FG-HST/01-01-hallsonde/documentation.pdf

# A handheld hall probe based on an Arduino Micro

Application for Arduino Uno WiFi XMAS Contest 2015
by Henning Janssen

This is a short documentation about a mobile handheld hall probe, which is based on an Arduino Micro. A battery powered Arduino evaluates via the analog input a hall effect sensor. The measured value will be shown on a display.
With this device it is possible to measure magnetic fields, i.e. the magnetic flux density as a constant and as a time-depending value. It is portable and independent from a power grid.

1 Hardware

The total system consists of a handheld (includes the Arduino, energy supply and display) and a set of external sensors. A picture of the whole measuring system is presented in Figure 1.


Figure 1: The handheld hall probe measuring the magnetic flux density of a permanent magnet

1.1 Set of probes

The magnetic flux density can be measured with different sensitivities. Therefor different hall effect sensors are used. The probes are equipped with ratiometric linear hall effect sensor ICs from Honeywell and Allegro. They need a supply voltage of VCC = 5 V and the output voltage depends linearly from the magnetic flux density. Figure 2 shows the three different sensor in their housings and a rod to hold the device into the measuring area.


Figure 2: Three types of sensor chips with different sensitivities can be used

1.2 Connection between measuring probes and handheld device

The different probe are connected with the handheld device with a 6-wire-ribbon cable. Two wires are used for the power supply. A third wire connects the voltage output of the hall sensor ICs to the handheld. Two of the remaining three wires are used to identify the different hall sensor ICs and thereby the different sensitivities.

1.3 The handheld in itself

The handheld is based on a Arduino Micro and a custom shield. An inside is given by Figure 3. The


Figure 3: View inside the handheld with the Arduino

device is powered by a nine-volt battery. The voltage for the microcontroller is directly regulated with a 7805 (fixed positive voltage regulator). Thus the Arduino Micro is powered via the port "+5V". The output of the 7805 is also used for the sensor chip, the display and the display background LED, too. The LCD is connected to the Arduino Micro in 4-bit mode and without the "rw contol" to minimise the wiring effort. As already mentioned in Chapter 1.2 the Arduino Micro can check automatically which sensor is linked. Therefor two digital ports are used to detect whether the corresponding channel is pulled to ground or 5 V. The measured signal is connected to the analog port "A0". The schematic of the developed shield can be found in Appendix II. The PCB layout was designed with EAGLE. It is shown in Appendix III.

2 Software

The Arduino Micro is flashed by the USB port with the Arduino IDE and Arduino code. The complete code is attached to Appendix I. The LCD is controled by the Arduino Micro using the LiquidCrystal Library. For timing purposes the TimerNull Library is used. It provides the functionality of the timer interrupts of the ATmega 32U4. To access the measured data the variables are initialised as volatile.

2.1 The setup() function

Within the setup() function the LCD will be started and static data will be written.
The measurement should be performed with an averaging. Every single point of measurement shall be taken every 50µs. For this reason the timer interrupt will be set to this time and be attached as interrupt.

2.2 The loop() function

Nothing will be perfomed. The Arduino Micro is just waiting for instructions from the timer interrupt.

2.3 The readHall() function and the sub-functions

Every times the timer interrupts the magnetic flux density will be measured and stored in a collection of all current measuring values. The number of all measuring values is increased by one. When 5000 measurements are performed the average will be calculated and shown on the display. To be able to measure also alternating fields the rms-value will be used as averaging method:

Brms =

vuuu
t

Pn=5000
i=1

Uin,i
1023 ·5000−Uref

kdivider 2

5000

Uin,i

: value returned by analogRead()

Uref: reference voltage which is returned by sensor at B = 0 T

kdivider: divider to convert measured voltage into a flux density, unit: mV
mT
The values Uref and kdivider depend on the type of hall sensor IC and will be set by the function setSensorTyp(). This functions evaluates the digital status (HIGH or LOW) on the inputs "A2"’ and "A3" and sets the sensor specific values to the volatile variables. If no sensor is identified an error is returned to the customer: Sensor?.
Finally the measured magnetic flux density will be shown on the display.

3 Appendix

I The Arduino code

/*
H all s o n d e

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

von Henning J a n s s e n

*/

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

vo id se tup ( )

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

se tSen s o rTyp ( ) ;

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

vo id loop ( ) {
// Warte und t u e n i c h t s

51 }

52
53 | vo id re a dH all ( )
54 | {
55 | i f (5000 == messwertAnz ) showRMS( ) ;

56
57 | messwert = ( ( ( f l o a t ) analogRead ( h a l l P i n ) ) /1023*5000 − h all R e f ) / s e n s o r d i v i d e r ;
58 | messwert = messwert *messwert ;
59 | messwertsammlung += messwert ;
60 | messwertAnz++;
61 | }

62
63 | vo id showRMS( )
64 | {
65 | messwert = s q r t ( messwertsammlung/messwertAnz ) ;
66 | // | m e s sw e r t = messwertsammlung / me s swer tAnz ;
67 | messwertsammlung = 0 ;
68 | messwertAnz = 0 ;

69
70 se tSen s o rTyp ( ) ;

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

80
81 | vo id se tSen s o rTyp ( )
82 | {
83 | S t ri n g senso rTyp ;
84 | pinMode (A2 , INPUT ) ;
85 | pinMode (A3 , INPUT ) ;
86 | i n t typPin4 = di gi t al R e a d (A2) ;
87 | i n t typPin5 = di gi t al R e a d (A3) ;
88 | i f (LOW == typPin4 & LOW == typPin5 ) { | // S e n s o r 1 = SS495A
89 | h all R e f = 2480;
90 | senso rTyp = " SS495A " ;
91 | s e n s o r d i v i d e r = 3 1.25 ;
92 | } e l s e i f (HIGH == typPin4 & LOW == typPin5 ) { | // S e n s o r 2 = SS496A
93 | h all R e f = 2470;
94 | senso rTyp = " SS496A " ;
95 | s e n s o r d i v i d e r = 25 ;
96 | } e l s e i f (HIGH == typPin4 & HIGH == typPin5 ) { | // S e n s o r 3 = A l l e g r o A1302K
97 | h all R e f = 2499;
98 | senso rTyp = " A1302K " ;
99 | s e n s o r d i v i d e r = 13 ;
100 | } e l s e senso rTyp = " Sensor ? " ;

101
102 | l c d . s e t C u r s o r (0 ,1 ) ;
103 | l c d . p r i n t ( senso rTyp ) ;

104
105 }

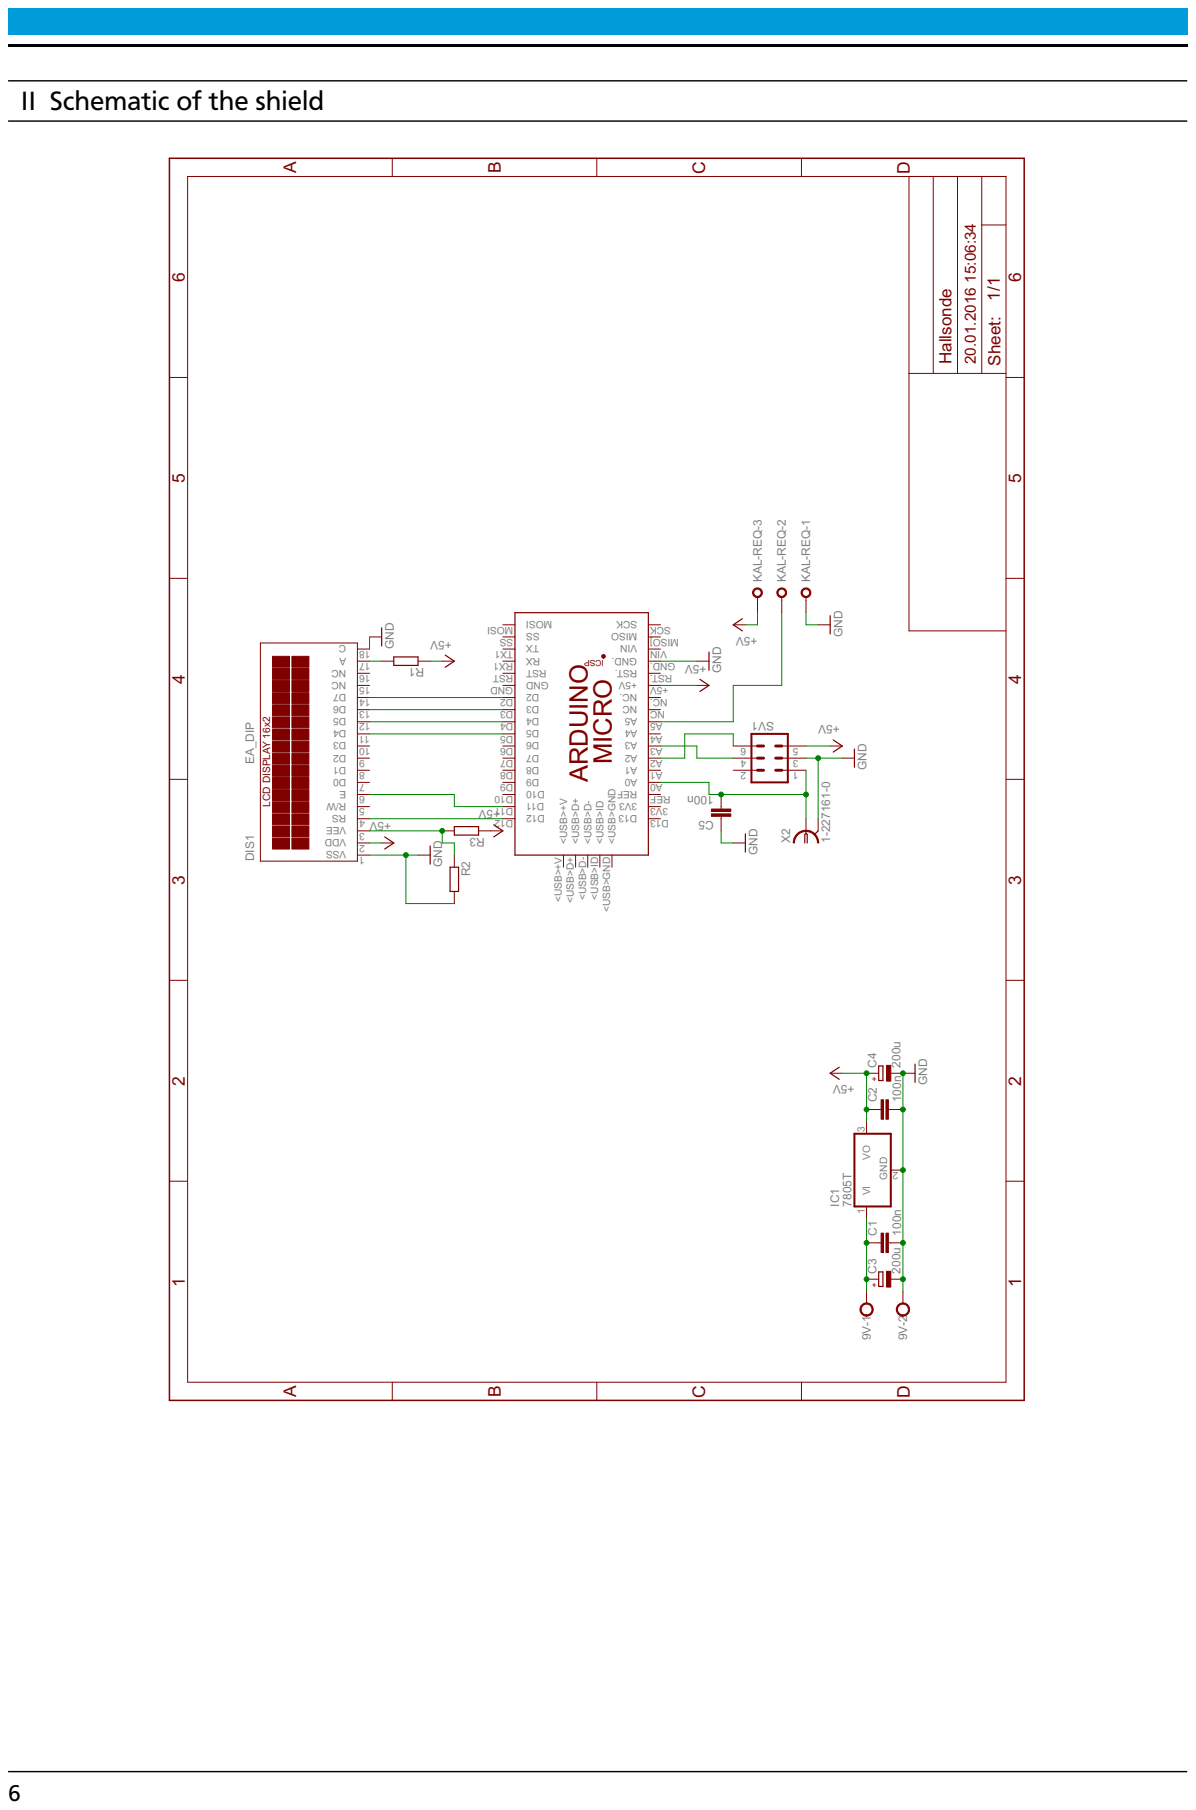
[picture p4: page 6]
EA_DIP; 100n 100n 200u 200u GND; V5+ GND; GND; n001 GND; DIS1 SSV 1 DDV; EEV; DNG; TSR; . TSR; . DNG; FER; <USB>GND; <USB>D+; <USB>+V; I SOM; OSI M; ] OSI M; KCS; <USB>ID; KAL-REQ-1; KAL-REQ-2; KAL-REQ-3; LCD DISPLAY 16x2; Hallsonde; 1/1 Sheet:; ARDUINOPSCI MICRO

II Schematic of the shield

<USB>+V NI V NI V

<USB>D- <USB>D- <USB>D+

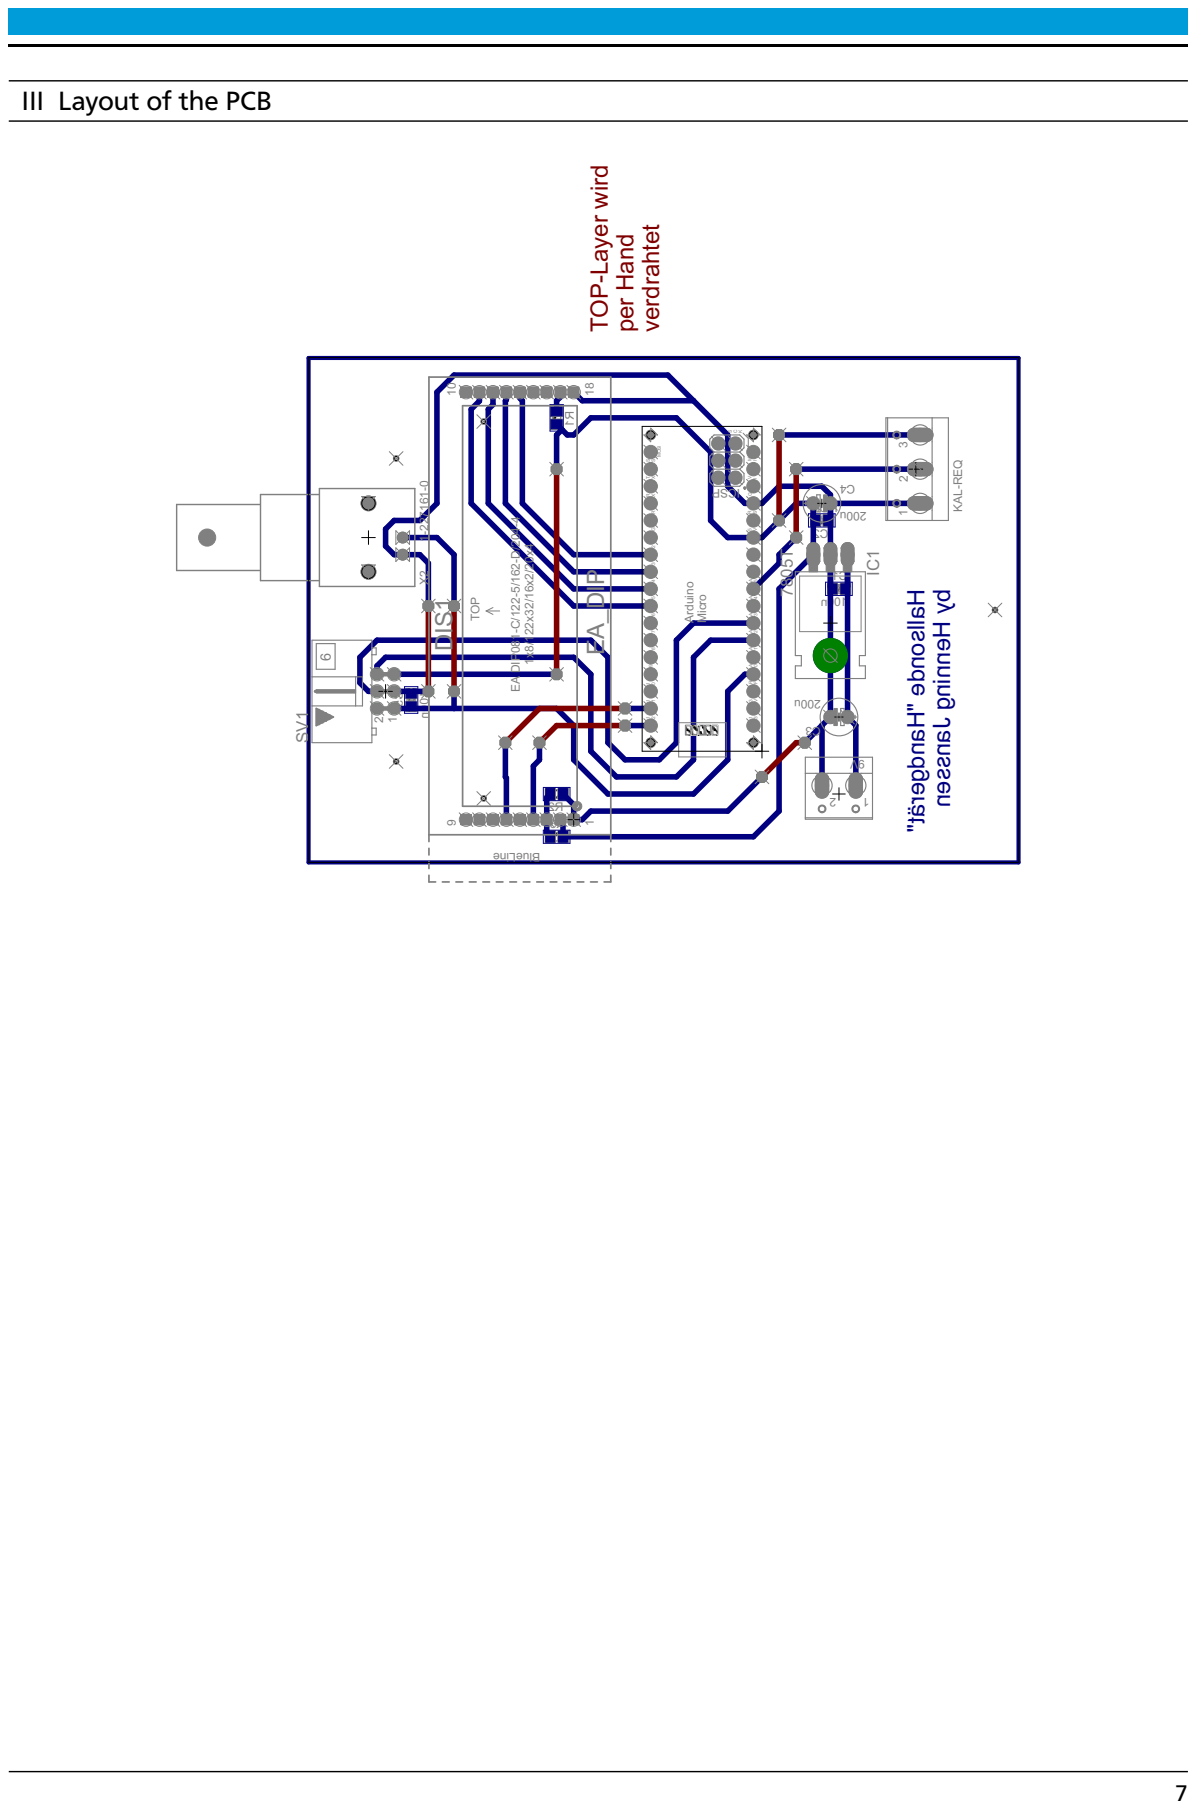
[picture p5: page 7]
per Hand; verdrahtet; EA DIP081-C/122-5/162-D/204-4; 1x8/122x32/16x2/20x4 TOP; Arduino Micro; S MOSI; DIS1; KAL-REQ; X2 EA_DIP

III Layout of the PCB

TOP-Layer wird

Hallsonde "Handgerät" by Henning Janssen
