FG-HST/01-01-hallsonde/Layout/Hallsonde_Schematic.pdf

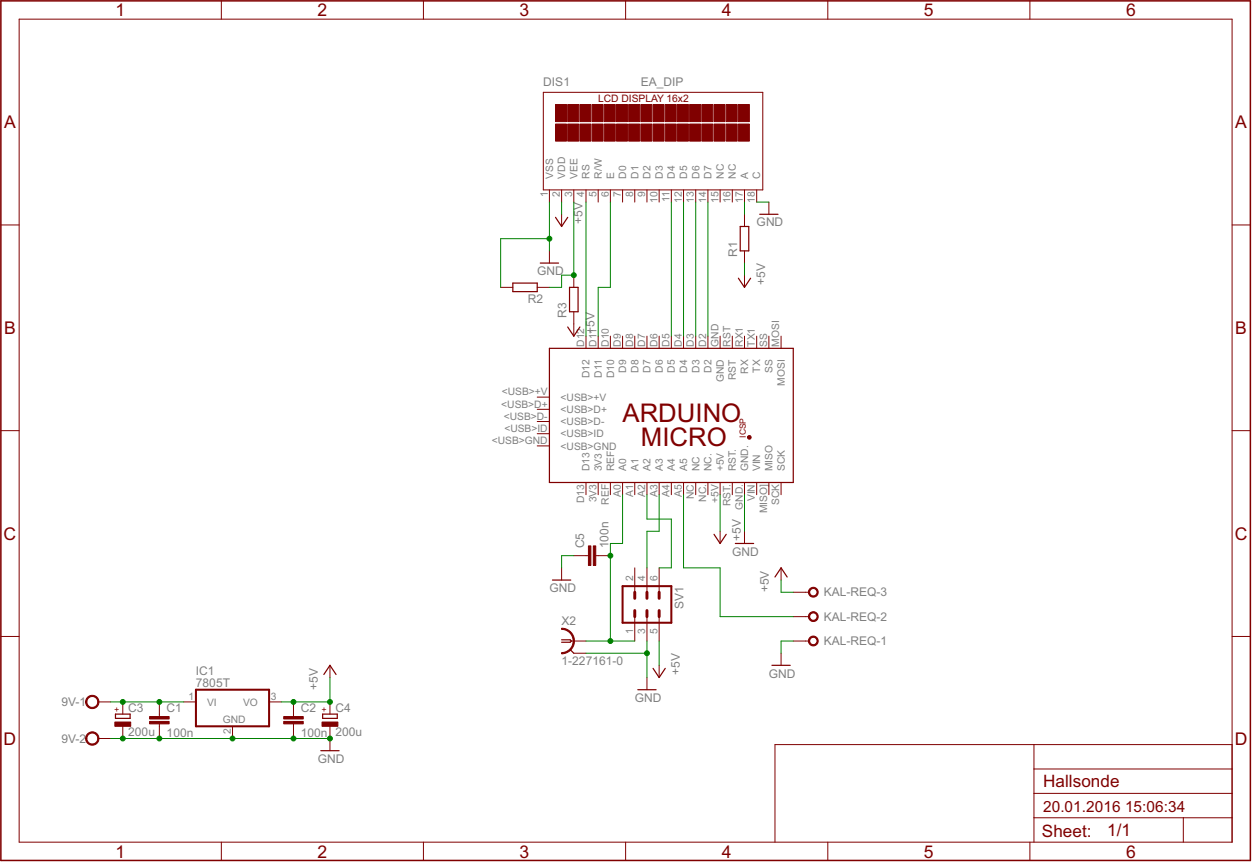
[picture p6: page 1]
