FG-HST/01-01-hallsonde/Layout/Hallsonde_board.pdf

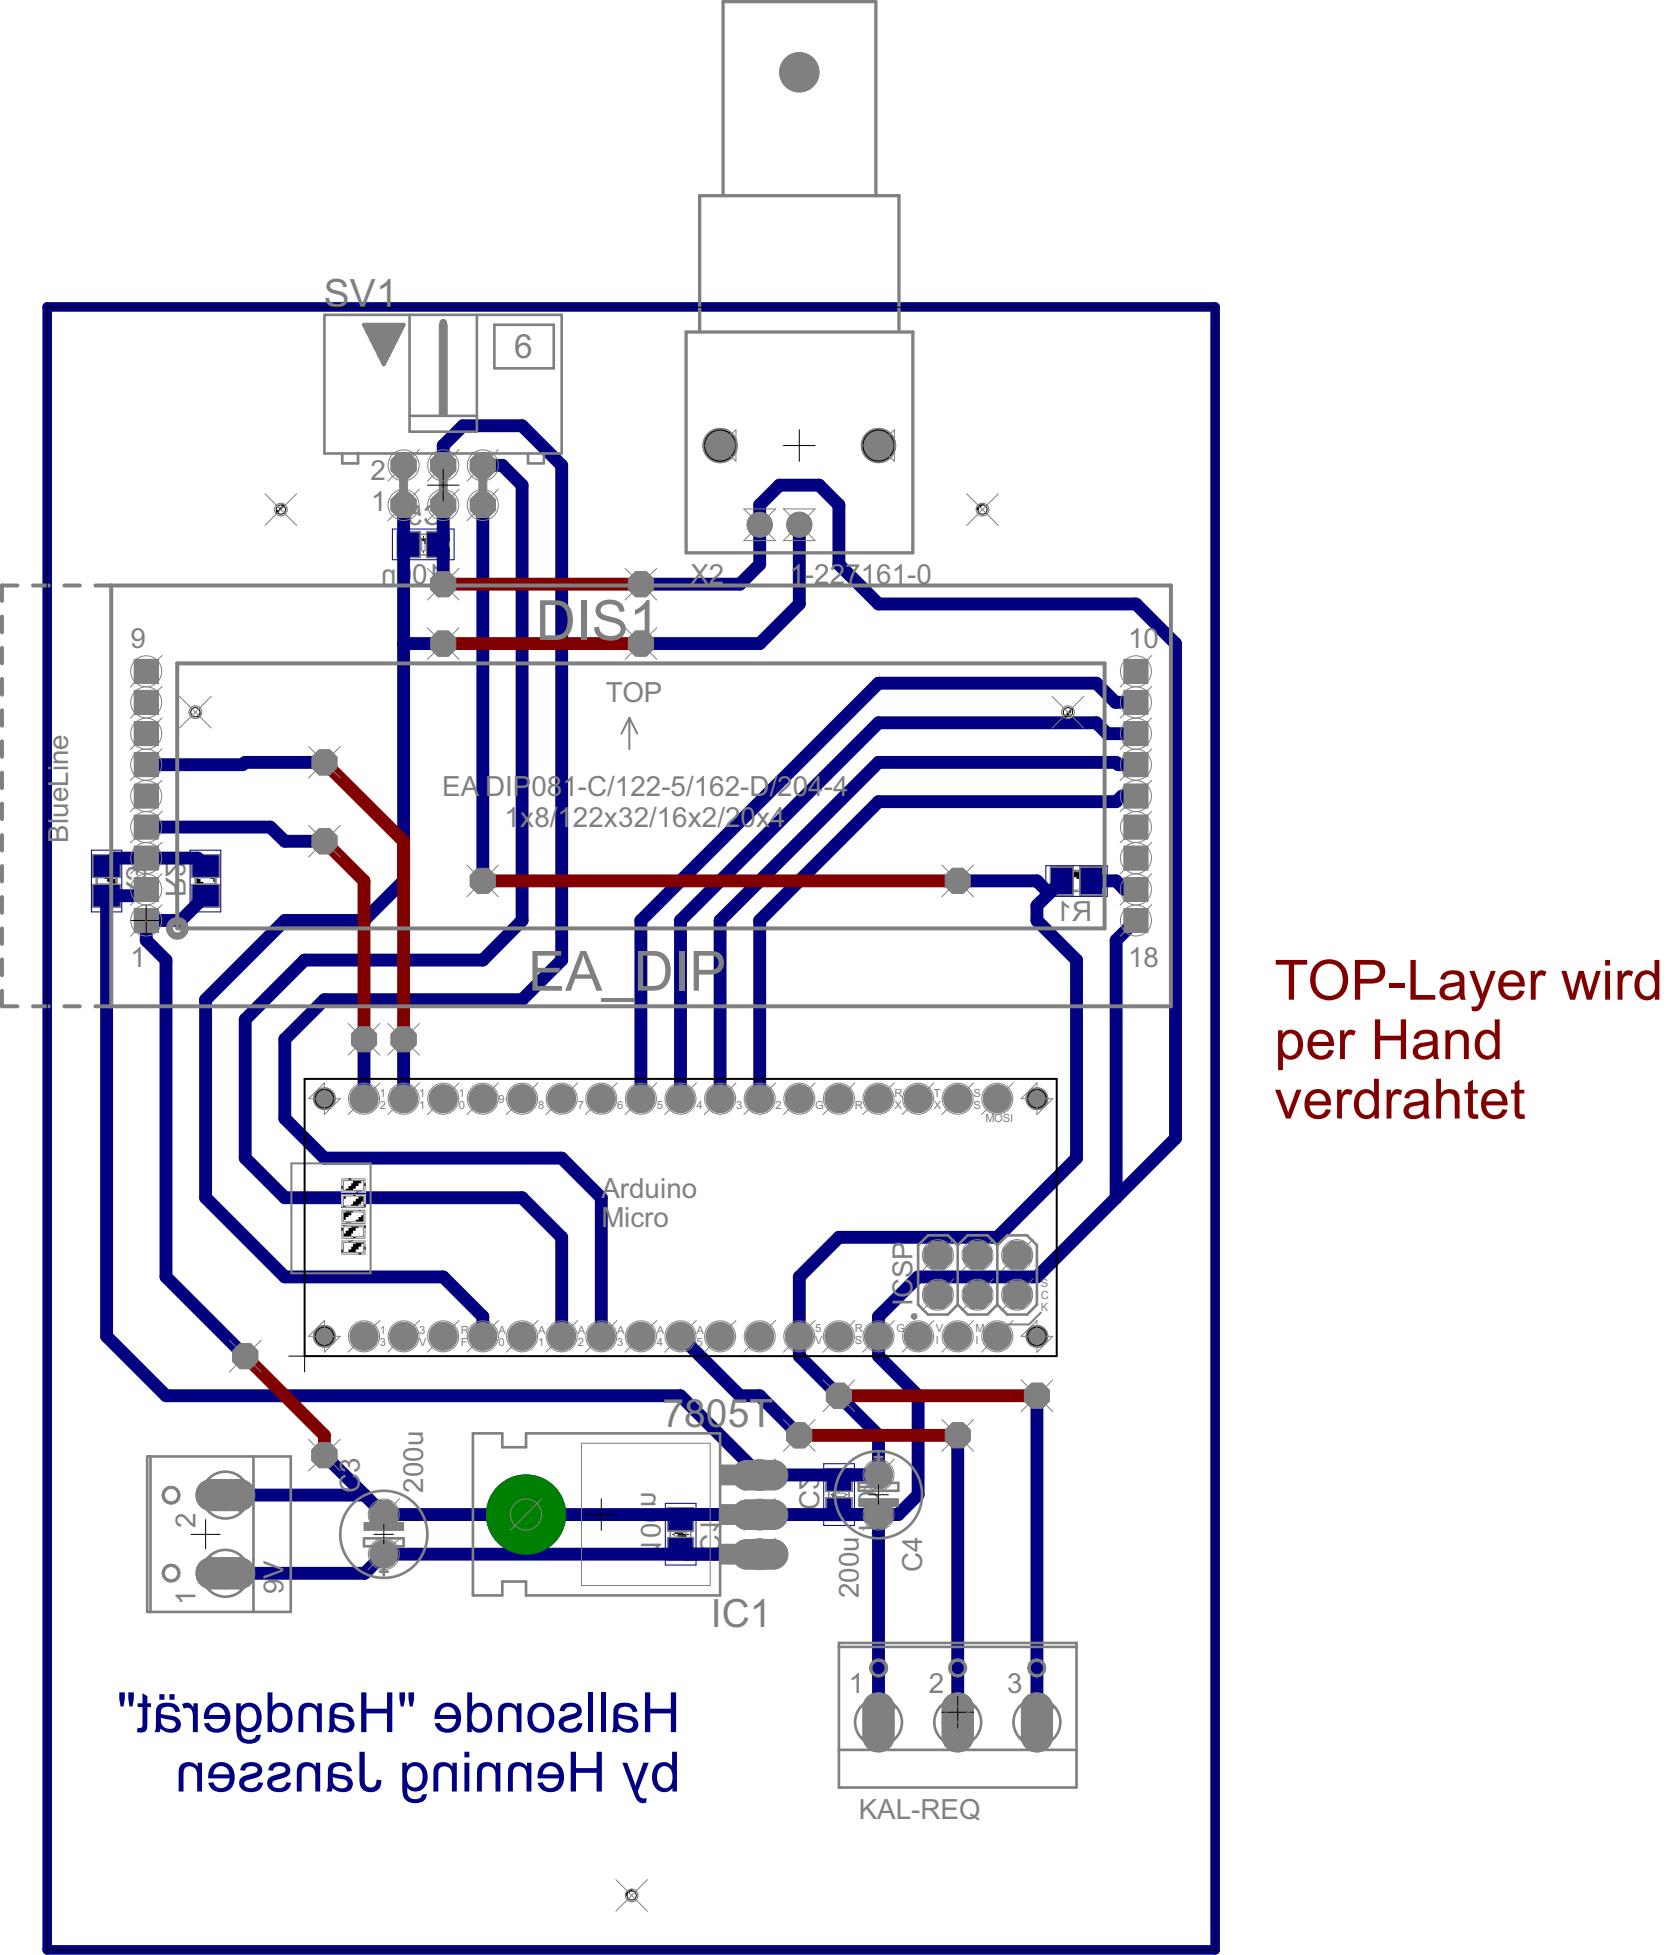
[picture p7: page 1]
