FG-HST/01-01-hallsonde/Layout/Hallsonde.brd

## EAGLE design Layout/Hallsonde.brd (2016-01-20)

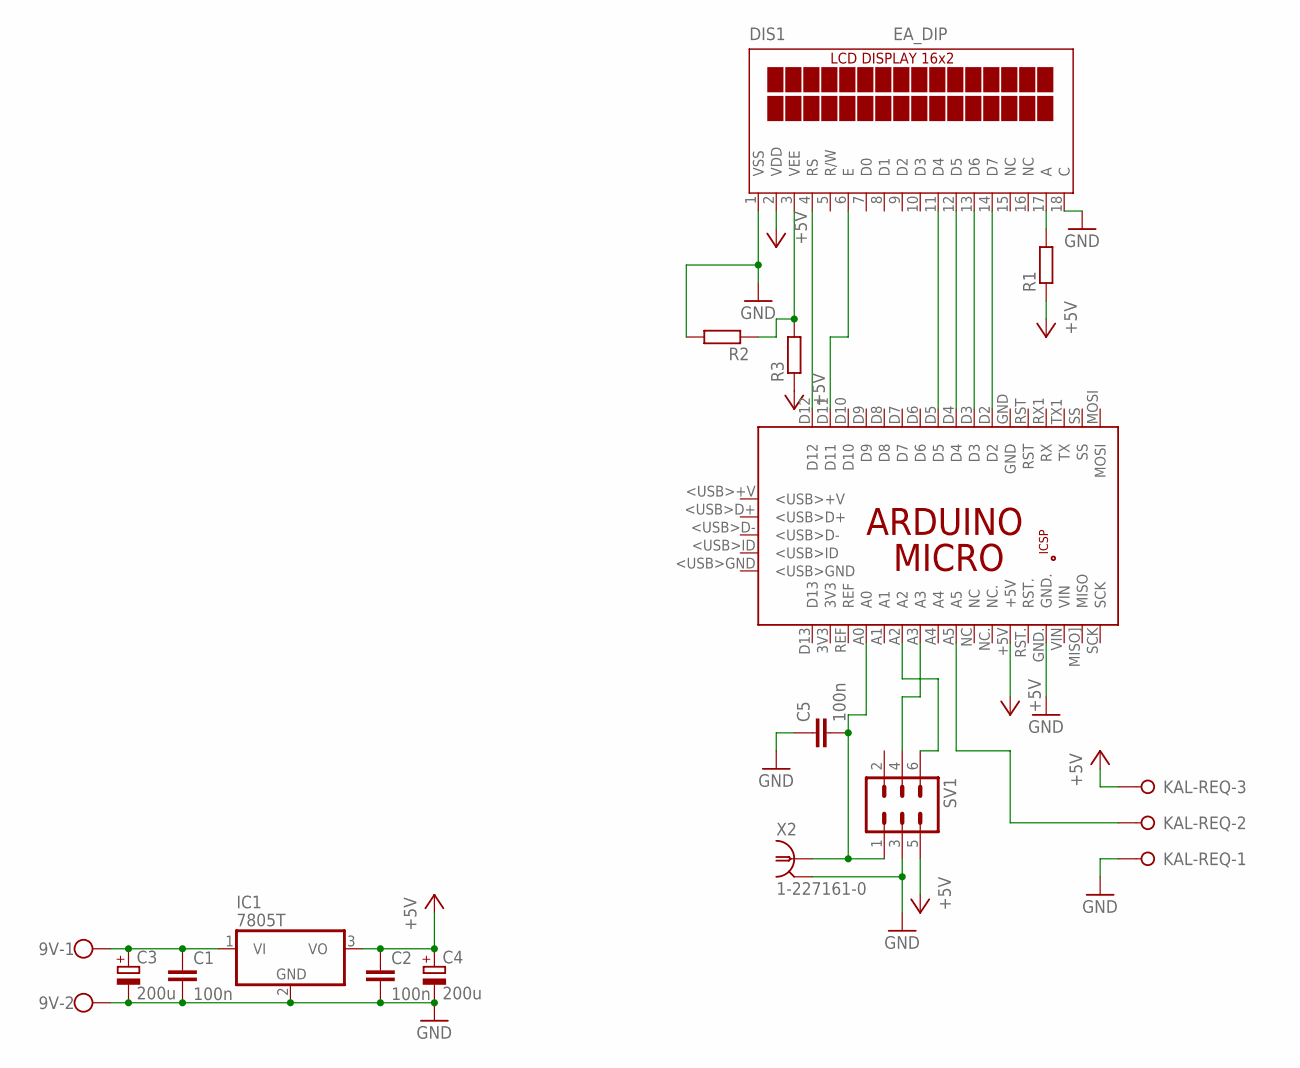
[picture p8: schematic Hallsonde.sch]

Parts:
9V: W237-102
C1, C2, C5: 100n; C0805
C3, C4: 200u; E2,5-6E
DIS1: EA_DIP
IC1: 7805T; TO220H
KAL-REQ: W237-3E
PCB1: ARDUINO_MICRO
R1, R2, R3: R-EU_M0805; M0805
SV1: ML6L
X2: 1-227161-0; AMP_227161

Connections:
+5V: C2.1, C4.+, DIS1.2 (VDD), IC1.3 (VO), KAL-REQ.3, PCB1.+5V, R1.1, R3.1, SV1.5
GND: 9V.2, C1.2, C2.2, C3.-, C4.-, C5.1, DIS1.1 (VSS), DIS1.18 (C), IC1.2 (GND), KAL-REQ.1, PCB1.GND., R2.2, SV1.3, X2.2
unnamed: 9V.1, C1.1, C3.+, IC1.1 (VI)
unnamed: DIS1.4 (RS), PCB1.D12
unnamed: DIS1.6 (E), PCB1.D11
unnamed: DIS1.11 (D4), PCB1.D5
unnamed: DIS1.12 (D5), PCB1.D4
unnamed: DIS1.13 (D6), PCB1.D3
unnamed: DIS1.14 (D7), PCB1.D2
unnamed: DIS1.17 (A), R1.2
unnamed: C5.2, PCB1.A0, SV1.1, X2.1
unnamed: PCB1.A3, SV1.4
unnamed: PCB1.A2, SV1.6
unnamed: KAL-REQ.2, PCB1.A5
unnamed: DIS1.3 (VEE), R2.1, R3.2

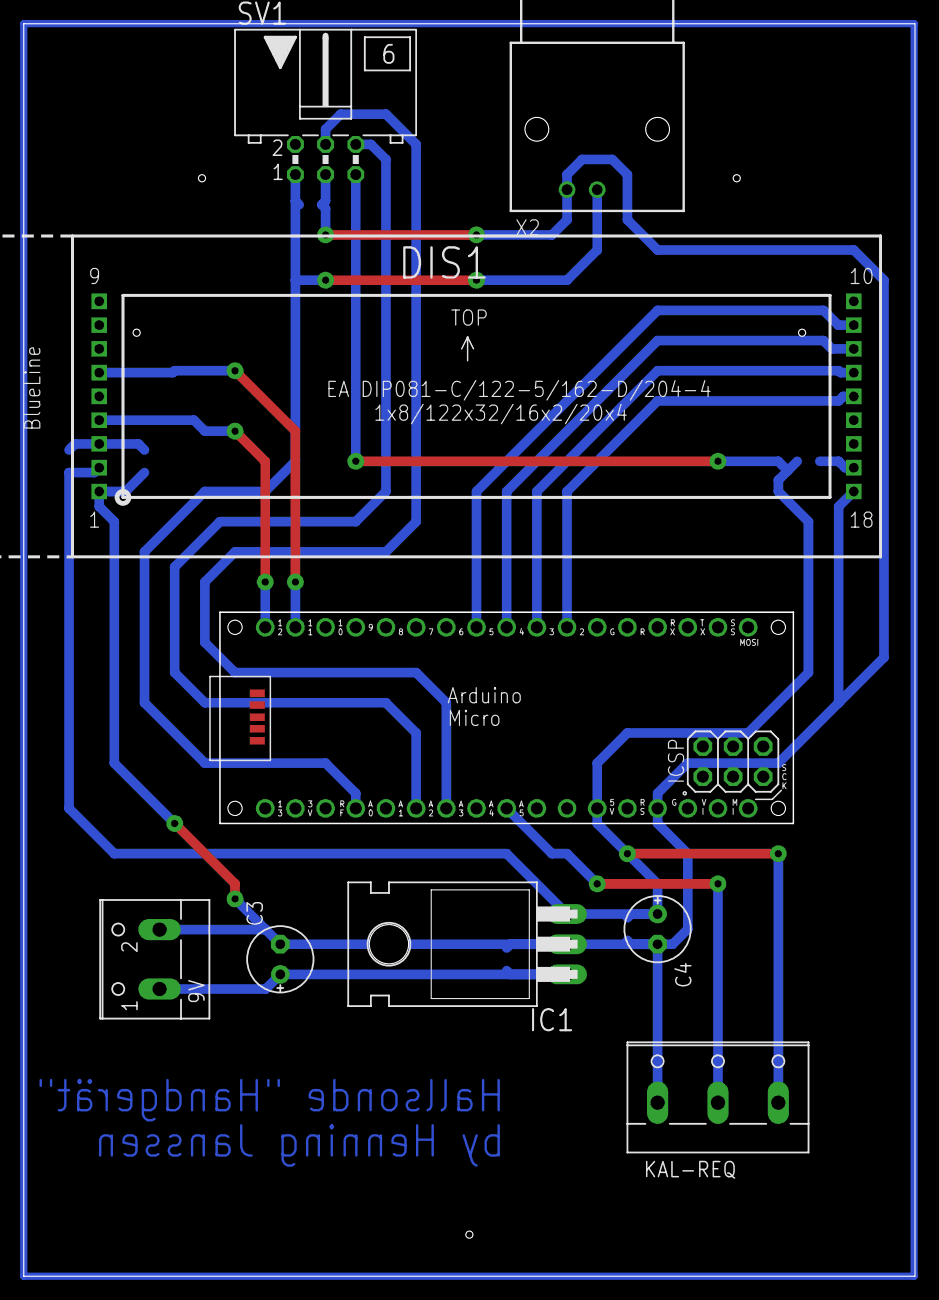
[picture p9: board Hallsonde.brd from above]

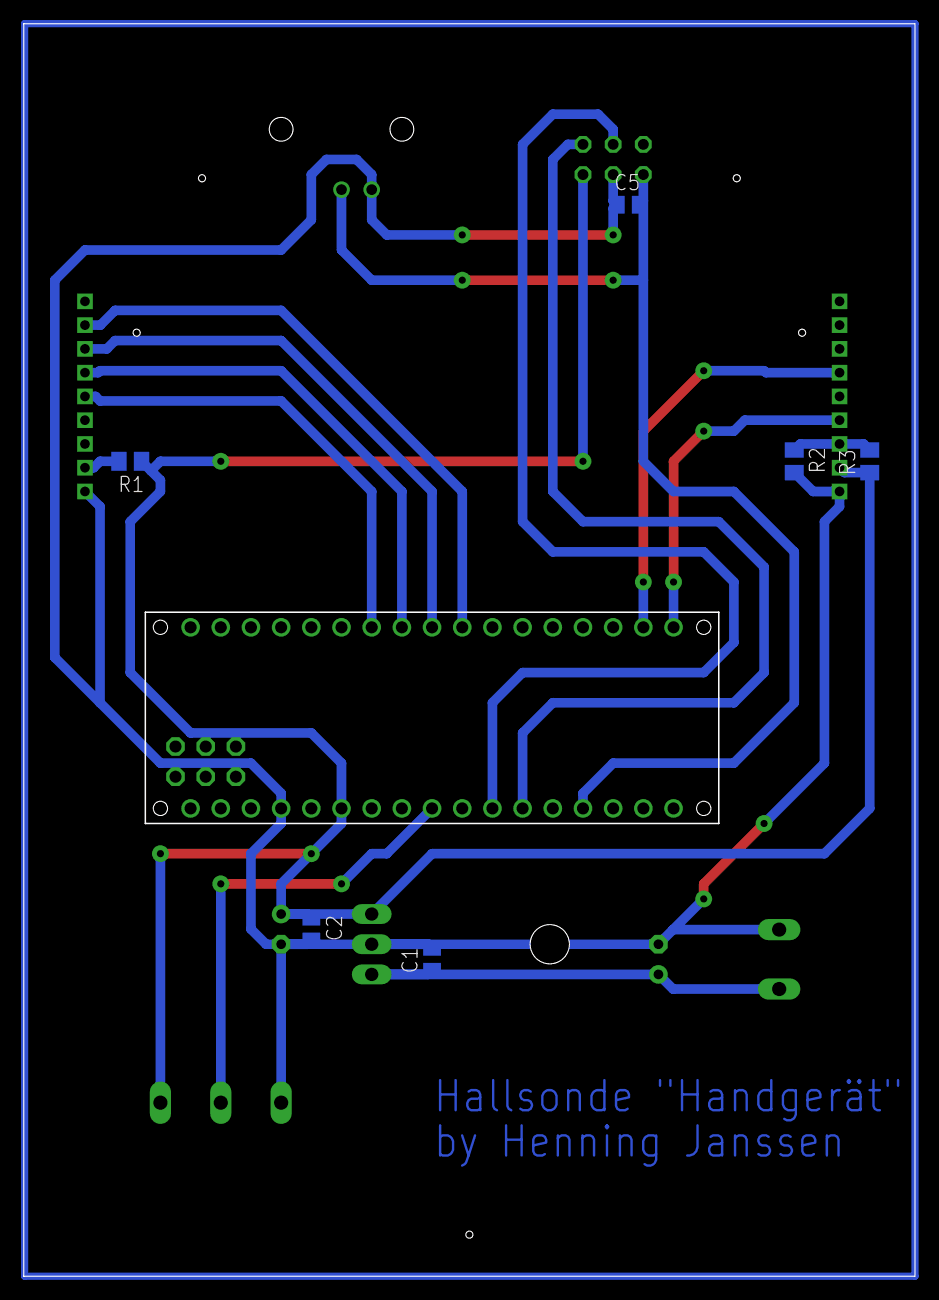
[picture p10: board Hallsonde.brd from below]

Board: 2 copper layers, 75.0 x 105.4 mm, 15 parts (6 on the bottom side), 15 nets.
